KeiranCantilina/Contactless-Conductivity-Sensor/README.md

# Contactless-Conductivity-Sensor

Repo for files and code relating to the development of an impedance based water conductivity sensor.
