KeiranCantilina/Contactless-Conductivity-Sensor/CCS physical schematic.png

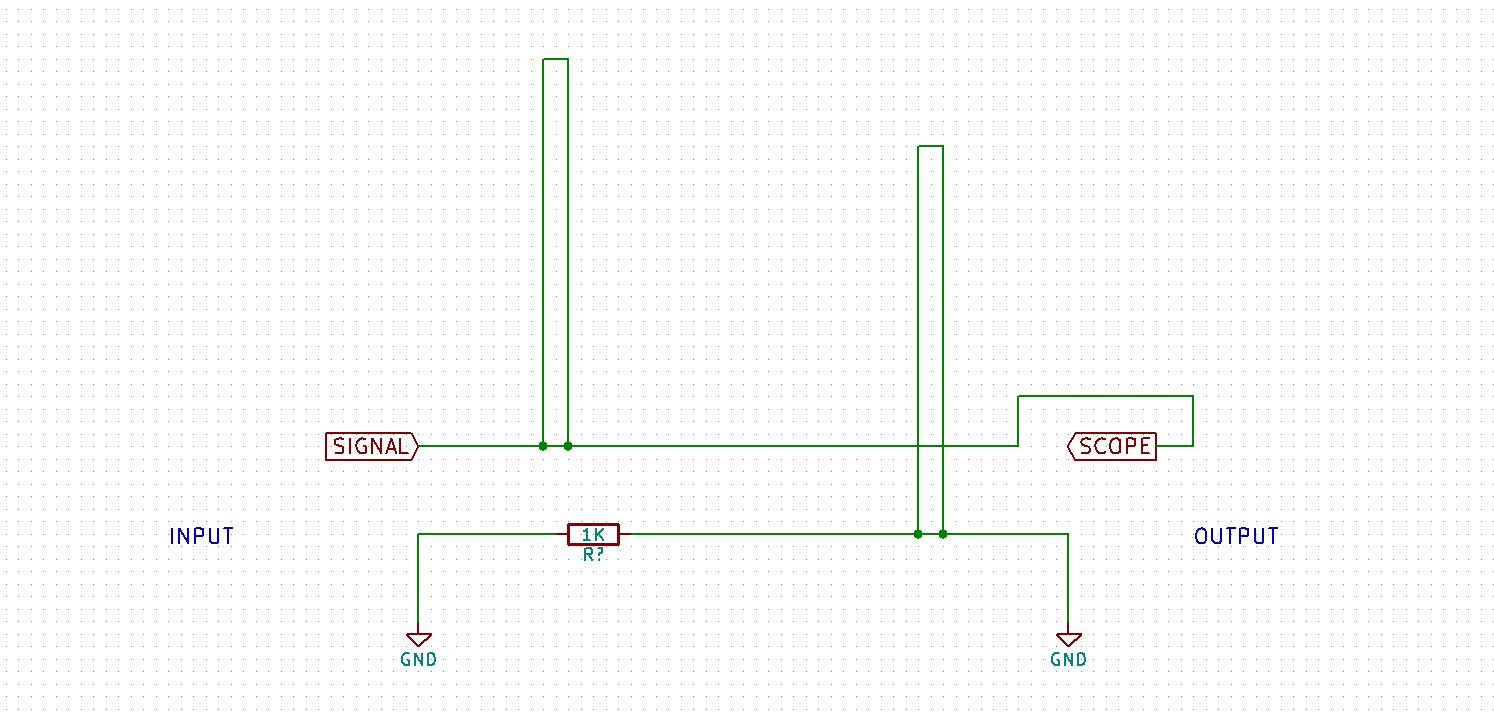
CCS physical schematic.png
