KeiranCantilina/Contactless-Conductivity-Sensor/CCS theoretical schematic.png

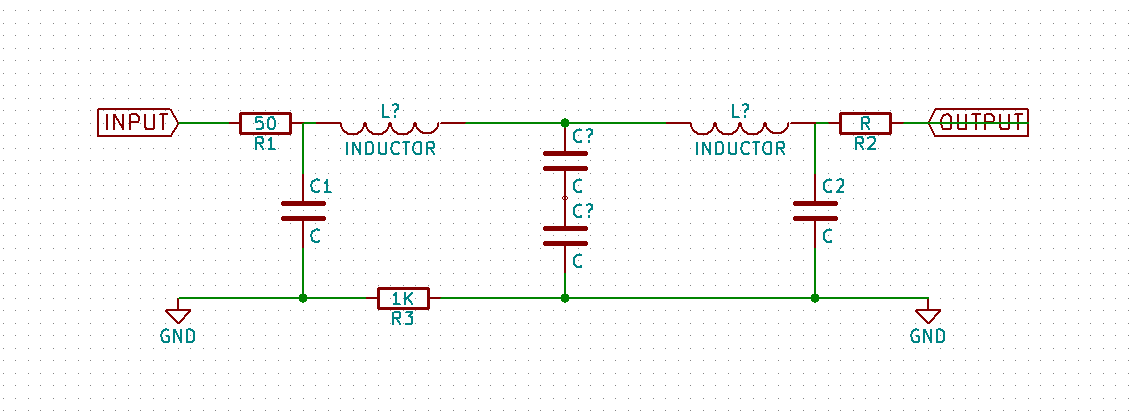
CCS theoretical schematic.png
