KeiranCantilina/Contactless-Conductivity-Sensor/contactless conductivity sensor_theoretical.sch

## KiCad design contactless conductivity sensor_theoretical.sch (2017-11-21)

Schematic: contactless conductivity sensor_theoretical.sch

Parts:
C1, C2: C
R1: 50
R2: R
R3: 1K
