KeiranCantilina/Contactless-Conductivity-Sensor/(commit log)

2018-02-14 Create conductivitysensor_tsunami_code.ino
    First version of code for Tsunami DDS board driving the sensor. Board outputs 1520696 Hz sine (6vpp) to sensor, sensor output is fed to board input, max voltage is sampled 100 times/sec and averaged for serial output at 1 Hz. Next version will probs add phase measurement capabilities.
2018-03-01 Create Calibrated multi-frequency measurement
    Implements measurements at both 0.8Mhz and 1.52 Mhz, using consensus comparison and averaging
2018-03-01 Create Calibration formulas
    calibration formulas from excel and https://mycurvefit.com/
2018-03-01 Add files via upload
    Calibration and test raw data (both sensor and ref sonde)
    [conductivity sensor data.xlsx]
2018-03-01 Create Calibration curves formatted for arduino
    formatted to remove "^" and replace with pow()
2018-03-01 Update and rename Calibrated multi-frequency measurement to Calibrated multi-frequency measurement.ino
    Added file extension, replaced cal curves
    [Calibrated multi-frequency measurement.ino]
2018-04-18 Create WildfireV4_adafruitIO_MQTT_example
    This is the Adafruit MQTT Library ESP8266 Example, modified to work on the Wildfire v4 boards made by WickedDevice (http://shop.wickeddevice.com/) using the WickedDevice ESP8266 AT Client library (found at https://github.com/WickedDevice/ESP8266_AT_Client).
    This bit of code serves as an example of how to get the Wildfire v4 to work with io.adafruit.com using MQTT, since the code shipped with the boards (supporting the sparkfun.io Phant servers) is now obsolete.
2018-05-06 Updates to word files
    [Data from Dan's machine.xlsx, Keiran data_air.xlsx, Keiran data_tap water.xlsx]
